greenenergyprojects/electro-vehicle-charger-met16/software/README.md

# Electrovehicle IEC 62196 Typ 2 charger

## Software

Each software product is located in a subdirectory.
For software detail information, see the file *README.md* inside the software subdirectory. 

### Overview

-----------------------------------------------------------------------------------------------------
 Subdirectory                                                         | Description
 :------------------------------------------------------------------  | :---------------------
 [atmega328p_u1/ev-charge-control](atmega328p_u1/ev-charge-control)   | Default software for the Atmega328P on Arduino (see [README.md](atmega328p_u1/ev-charge-control/README.md)).
