greenenergyprojects/electro-vehicle-charger-met16/kicad/README.md

# Electrovehicle IEC 62196 Typ 2 charger met-16

## Issues / Test results

Issues can be found in file [dist/README.md](dist/README.md).

## PCB / Kicad project

Design files can be found in the [same directory](./).

## Tapeout / Manufactering data

Manufactering data can be found in subdirectory [dist](dist).
