greenenergyprojects/electro-vehicle-charger-met16/docs/messung_netzspannung_2019-11-24/README.md

# Measurment Grid-Voltage

* yellow curve: grid voltage
  RIGOL MSO2204, 1:10 probe on resistor voltage divider 1:5 (ebay 253045608366)
  1/50: 2V/DIV => 100V/DIV

* blue curve: voltage sensor output MVOLT (J9-2)
