greenenergyprojects/electro-vehicle-charger-met16/docs/EV-AC-Charging.png

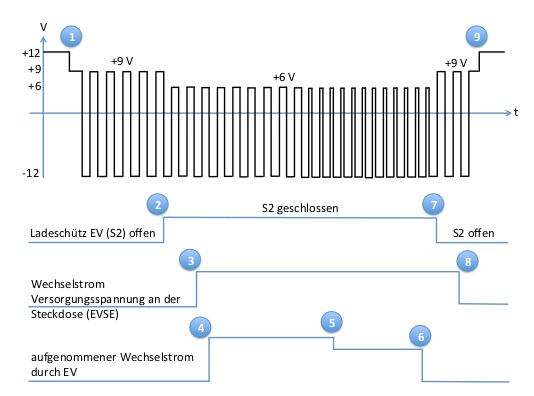
docs/EV-AC-Charging.png
