greenenergyprojects/electro-vehicle-charger-met16/kicad/dist/ev-charger-met16_3dview-bottom.png

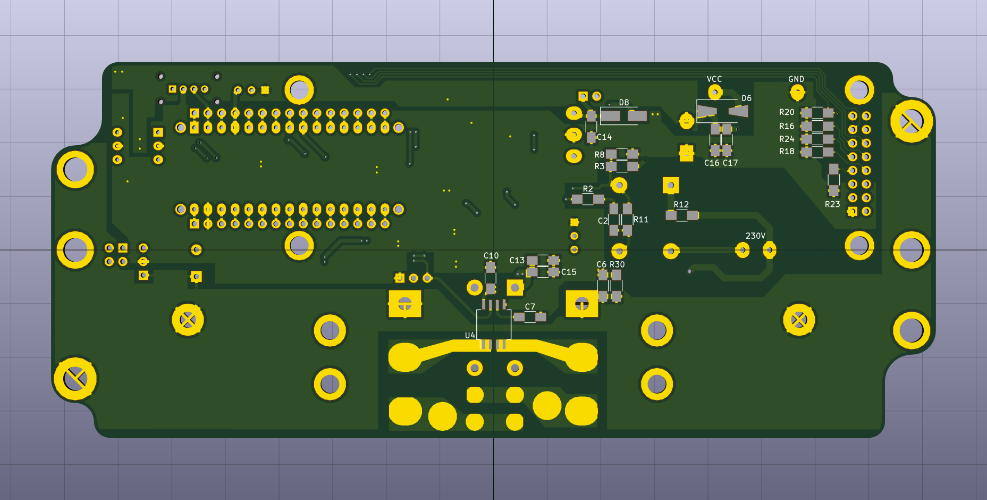
kicad/dist/ev-charger-met16_3dview-bottom.png
