greenenergyprojects/electro-vehicle-charger-met16/kicad/dist/ev-charger-met16_3dview-top.png

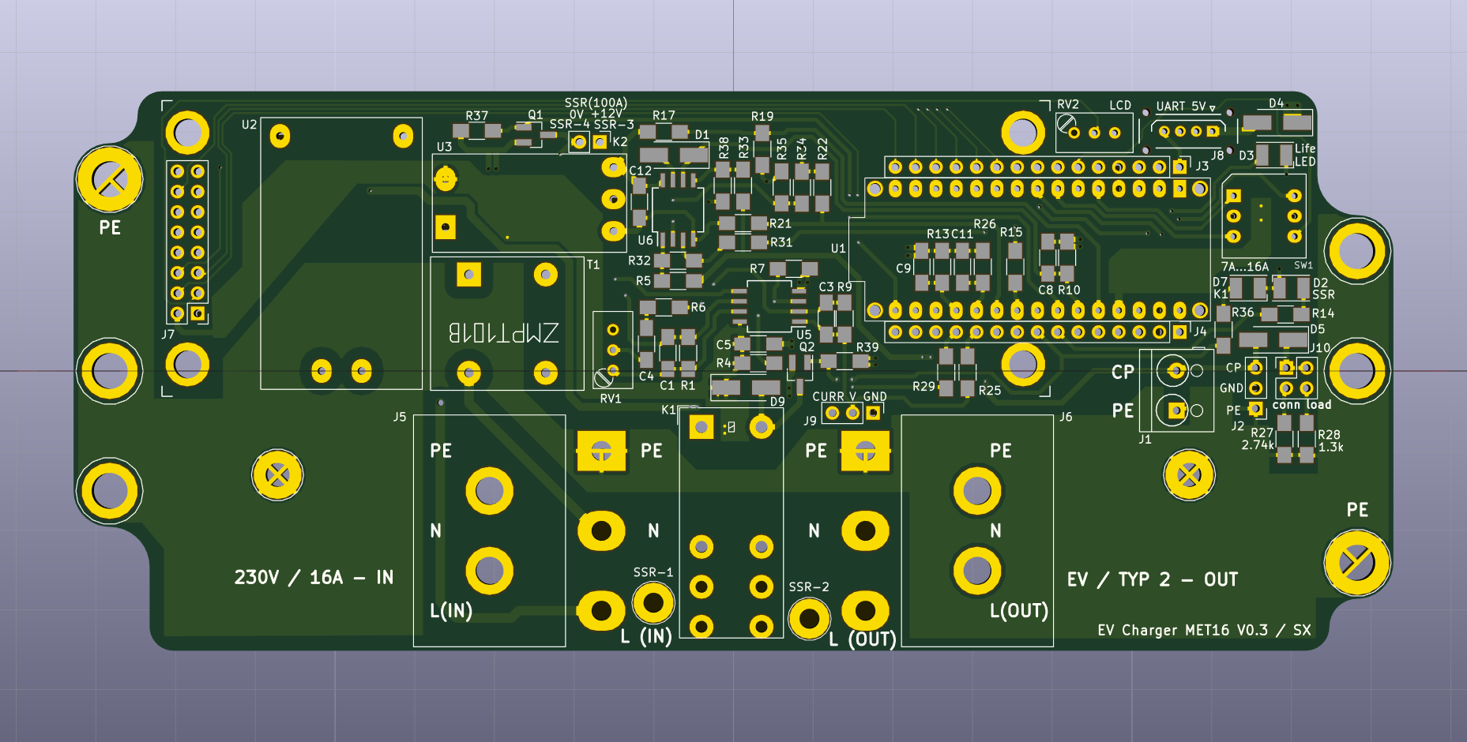
kicad/dist/ev-charger-met16_3dview-top.png
