greenenergyprojects/electro-vehicle-charger-met16/kicad/dist/ev-charger-met16_v0.3-open-withoutLCD.jpg

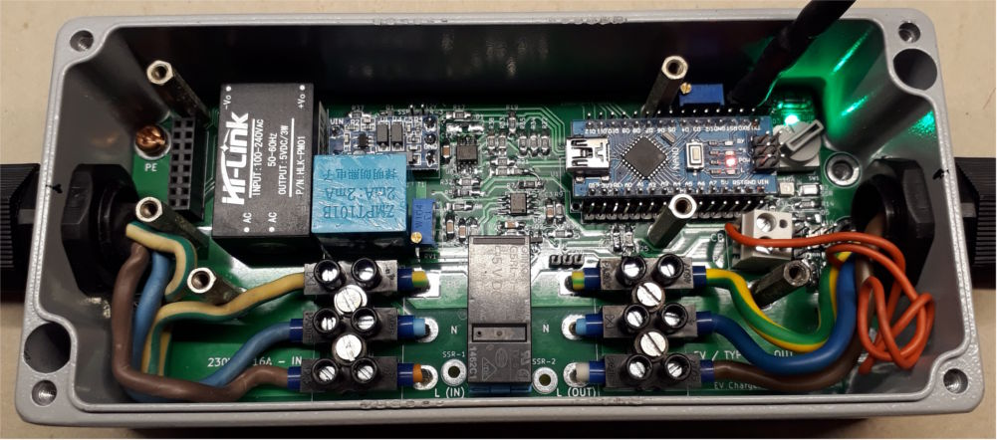
kicad/dist/ev-charger-met16_v0.3-open-withoutLCD.jpg
