greenenergyprojects/electro-vehicle-charger-met16/kicad/problems/voltage-tranformer_ebay-232542976388/zmpt101b-schematic.png

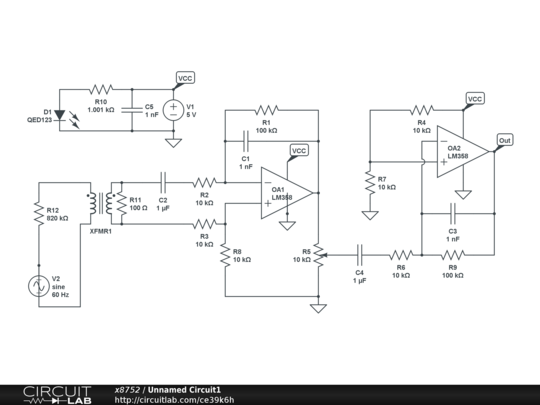
kicad/problems/voltage-tranformer_ebay-232542976388/zmpt101b-schematic.png
