greenenergyprojects/electro-vehicle-charger-met16/kicad/dist/ev-charger-met16_bom.ods

Source: | /work/sx/gep/electro-vehicle-charger-met16/kicad/ev-charger-met16.sch
Date: | So 05 Aug 2018 16:30:13 CEST
Tool: | Eeschema 4.0.7-e2-6376~61~ubuntu18.04.1
Component Count: | 91
Ref | Value | Footprint | Datasheet | Manufacturer | Vendor
C1 | 1nF | Capacitors_SMD:C_1206_HandSoldering
C2 | 1uF | Capacitors_SMD:C_1206_HandSoldering
C3 | 1nF | Capacitors_SMD:C_1206_HandSoldering
C4 | 1uF | Capacitors_SMD:C_1206_HandSoldering
C5 | 22nF | Capacitors_SMD:C_1206_HandSoldering
C6 | 100n | Capacitors_SMD:C_1206_HandSoldering
C7 | 1n | Capacitors_SMD:C_1206_HandSoldering
C8 | 1u | Capacitors_SMD:C_1206_HandSoldering
C9 | 100n | Capacitors_SMD:C_1206_HandSoldering
C10 | 100n | Capacitors_SMD:C_1206_HandSoldering
C11 | 100n | Capacitors_SMD:C_1206_HandSoldering
C12 | 22n | Capacitors_SMD:C_1206_HandSoldering
C13 | 1u | Capacitors_SMD:C_1206_HandSoldering
C14 | 220n | Capacitors_SMD:C_1206_HandSoldering
C15 | 100n | Capacitors_SMD:C_1206_HandSoldering
C16 | 100n | Capacitors_SMD:C_1206_HandSoldering
C17 | 1u | Capacitors_SMD:C_1206_HandSoldering
D1 | D_Schottky | Diodes_SMD:D_SMA_Handsoldering
D2 | rot | LEDs:LED_PLCC-2
D3 | grün | LEDs:LED_PLCC-2
D4 | D_Schottky | Diodes_SMD:D_SMA_Handsoldering
D5 | D_Schottky | Diodes_SMD:D_SMA_Handsoldering
D6 | D_Schottky | Diodes_SMD:D_SMA-SMB_Universal_Handsoldering
D7 | blau | LEDs:LED_PLCC-2
D8 | D_Schottky | Diodes_SMD:D_SMA_Handsoldering
D9 | D_Schottky | Diodes_SMD:D_SMA_Handsoldering
J1 | Screw_Terminal_01x02 | Project:Terminalblock-2x-5mm
J2 | Conn_01x03 | Pin_Headers:Pin_Header_Straight_1x03_Pitch2.54mm
J3 | Conn_01x15 | Pin_Headers:Pin_Header_Straight_1x15_Pitch2.54mm
J4 | Conn_01x15 | Pin_Headers:Pin_Header_Straight_1x15_Pitch2.54mm
J5 | Lusterklemme-6mm2-40A | Project:Lusterklemme-PA30P-6mm2-40A-x3-N
J6 | Lusterklemme-6mm2-40A | Project:Lusterklemme-PA30P-6mm2-40A-x3-S
J7 | LCD-Sure | Project:LCD-Sure-shifted-064
J8 | UART-Harwin4 | Connectors_Harwin:Harwin_LTek-Male_04x2.00mm_Straight_StrainRelief
J9 | Conn_01x03 | Pin_Headers:Pin_Header_Straight_1x03_Pitch2.54mm
J10 | Conn_02x02_Counter_Clockwise | Pin_Headers:Pin_Header_Straight_2x02_Pitch2.54mm
J12 | Conn_01x01 | Project:Solder_via_5x5_forWire4mm2
J13 | Conn_01x01 | Project:Solder_via_5x5_forWire4mm2
K1 | Omron_G5RL-1-E | Relays_THT:Relay_DPDT_Panasonic_JW2
K2 | Conn_01x02 | Pin_Headers:Pin_Header_Straight_1x02_Pitch2.54mm
Q1 | FDV303N | TO_SOT_Packages_SMD:SOT-23_Handsoldering
Q2 | FDV303N | TO_SOT_Packages_SMD:SOT-23_Handsoldering
R1 | 100k | Resistors_SMD:R_1206_HandSoldering
R2 | 10k | Resistors_SMD:R_1206_HandSoldering
R3 | 10k | Resistors_SMD:R_1206_HandSoldering
R4 | 10k | Resistors_SMD:R_1206_HandSoldering
R5 | 1k | Resistors_SMD:R_1206_HandSoldering
R6 | 10k | Resistors_SMD:R_1206_HandSoldering
R7 | 10k | Resistors_SMD:R_1206_HandSoldering
R8 | 10k | Resistors_SMD:R_1206_HandSoldering
R9 | 100k | Resistors_SMD:R_1206_HandSoldering
R10 | 100M | Resistors_SMD:R_1206_HandSoldering
R11 | 100 | Resistors_SMD:R_1206_HandSoldering
R12 | 820k | Resistors_SMD:R_1206_HandSoldering
R13 | 1k | Resistors_SMD:R_1206_HandSoldering
R14 | 560R | Resistors_SMD:R_1206_HandSoldering
R15 | 560R | Resistors_SMD:R_1206_HandSoldering
R16 | 47k | Resistors_SMD:R_1206_HandSoldering
R17 | 33k | Resistors_SMD:R_1206_HandSoldering
R18 | 47k | Resistors_SMD:R_1206_HandSoldering
R19 | 2k2 | Resistors_SMD:R_1206_HandSoldering
R20 | 100k | Resistors_SMD:R_1206_HandSoldering
R21 | 27k | Resistors_SMD:R_1206_HandSoldering
R22 | 10k | Resistors_SMD:R_1206_HandSoldering
R23 | 47k | Resistors_SMD:R_1206_HandSoldering
R24 | 47k | Resistors_SMD:R_1206_HandSoldering
R25 | 3k3 | Resistors_SMD:R_1206_HandSoldering
R26 | 1k | Resistors_SMD:R_1206_HandSoldering
R27 | 2.74k | Resistors_SMD:R_1206_HandSoldering
R28 | 1.3k | Resistors_SMD:R_1206_HandSoldering
R29 | 47k | Resistors_SMD:R_1206_HandSoldering
R30 | 0R | Resistors_SMD:R_1206_HandSoldering
R31 | 15k | Resistors_SMD:R_1206_HandSoldering
R32 | 100M | Resistors_SMD:R_1206_HandSoldering
R33 | 120k | Resistors_SMD:R_1206_HandSoldering
R34 | 33k | Resistors_SMD:R_1206_HandSoldering
R35 | 3k3 | Resistors_SMD:R_1206_HandSoldering
R36 | 560R | Resistors_SMD:R_1206_HandSoldering
R37 | 47k | Resistors_SMD:R_1206_HandSoldering
R38 | 10k | Resistors_SMD:R_1206_HandSoldering
R39 | 47k | Resistors_SMD:R_1206_HandSoldering
RV1 | 100k | Potentiometers:Potentiometer_Trimmer_Bourns_3296W
RV2 | 10K | Potentiometers:Potentiometer_Trimmer_Bourns_3296W
SW1 | SW_PT65-501 | Project:SW_DIP_x3_W7.62mm_PT65-501
T1 | Transformer_1P_1S | Project:Transformer-zmpt101b_ebay-121438904988
U1 | ARDUINO-NANO | Project:Arduino-Nano
U2 | HLK-PM01 | Project:HLK_PM01
U3 | ebay-253052736386 | Project:ebay-253052736386
U4 | ACS712 | Housings_SOIC:SO-8_5.3x6.2mm_Pitch1.27mm
U5 | LM358 | Housings_SOIC:SO-8_5.3x6.2mm_Pitch1.27mm
U6 | AD822 | Housings_SOIC:SO-8_5.3x6.2mm_Pitch1.27mm
