greenenergyprojects/electro-vehicle-charger-met16/kicad/problems/voltage-tranformer_ebay-232542976388/oszi.jpg

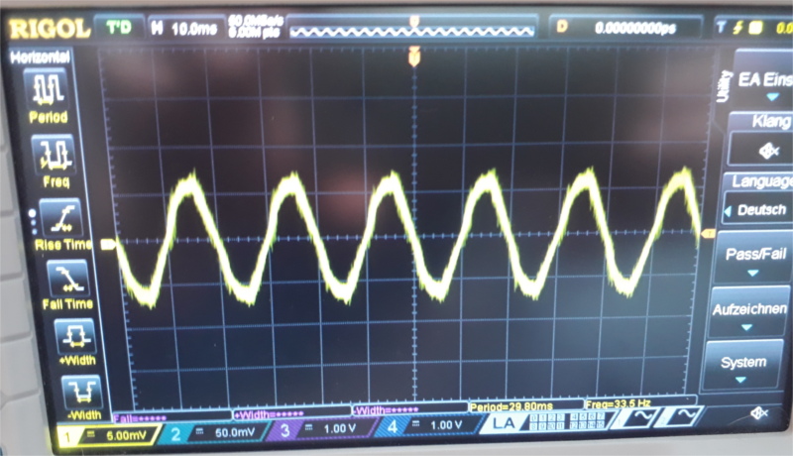
kicad/problems/voltage-tranformer_ebay-232542976388/oszi.jpg
