greenenergyprojects/electro-vehicle-charger-met16/kicad/dist/ev-charger-met16_schematic.pdf

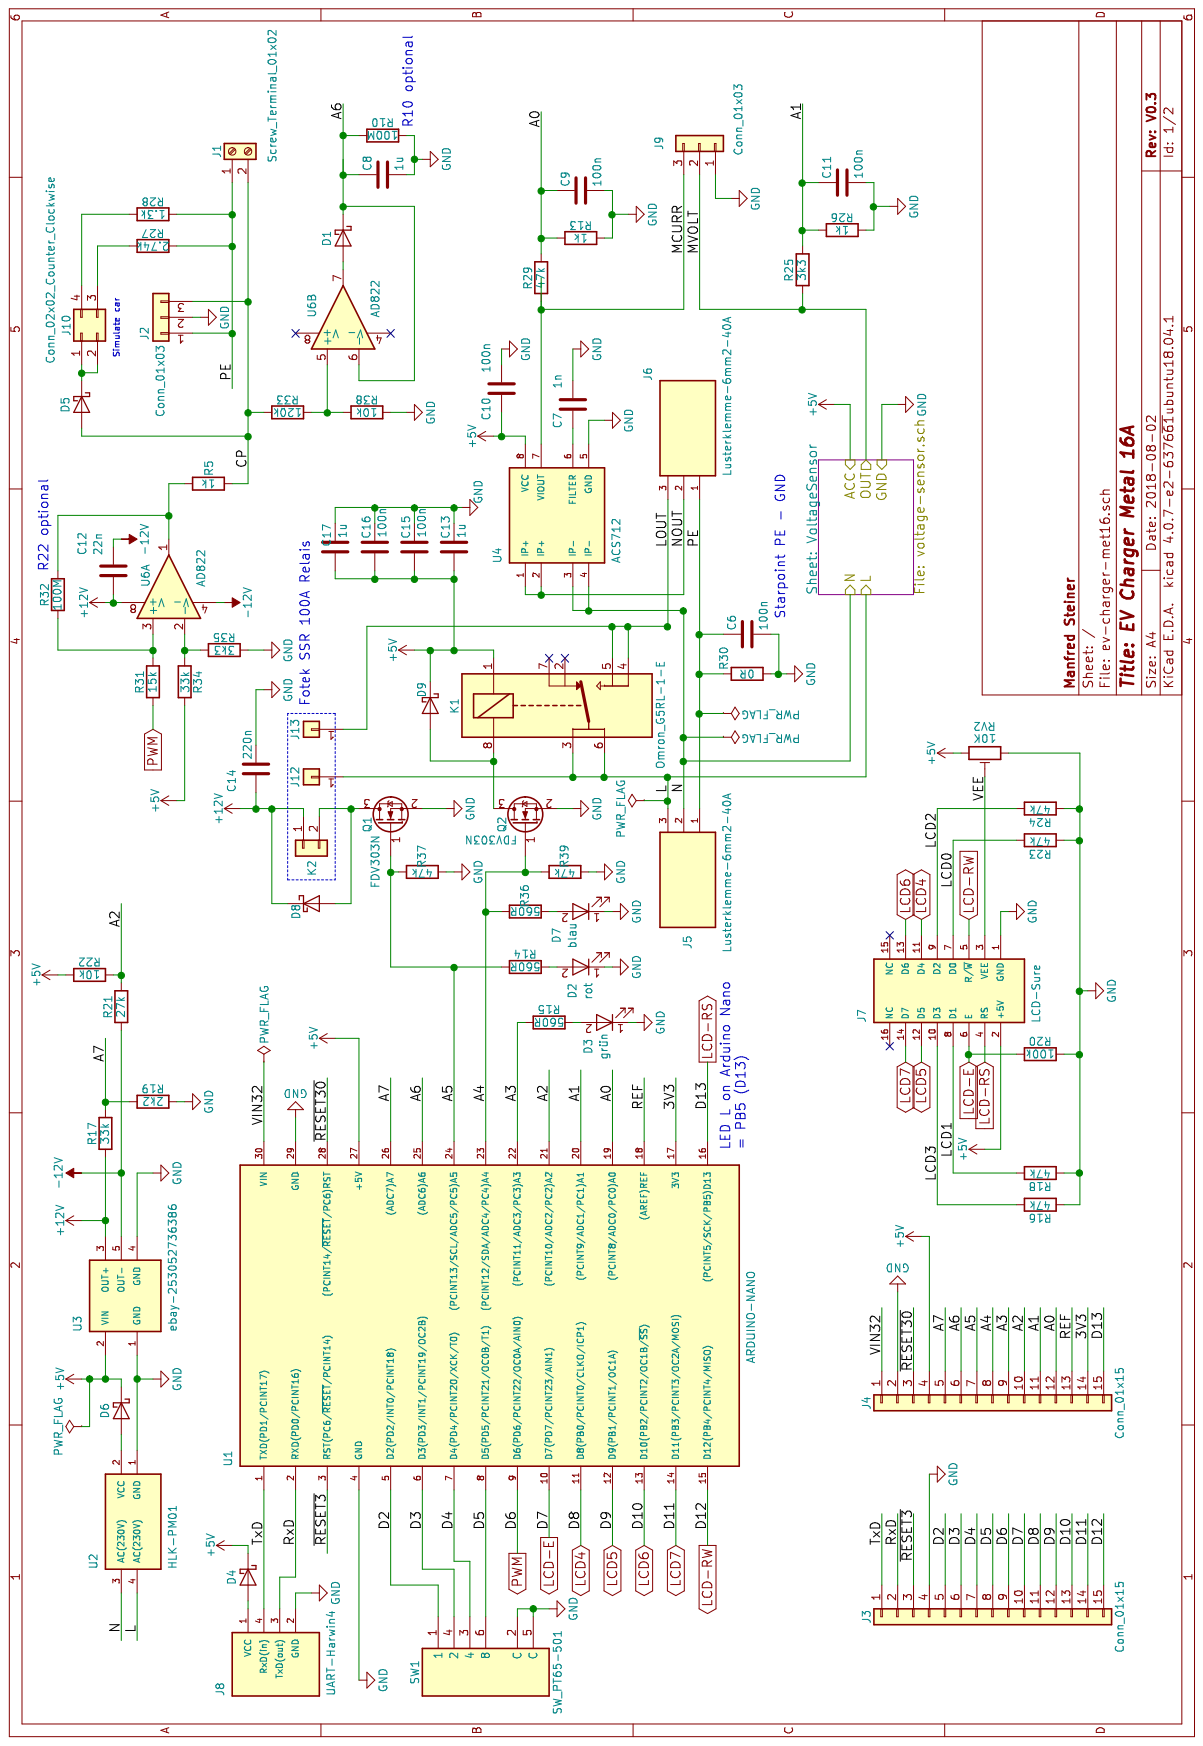
[picture p10: page 1]

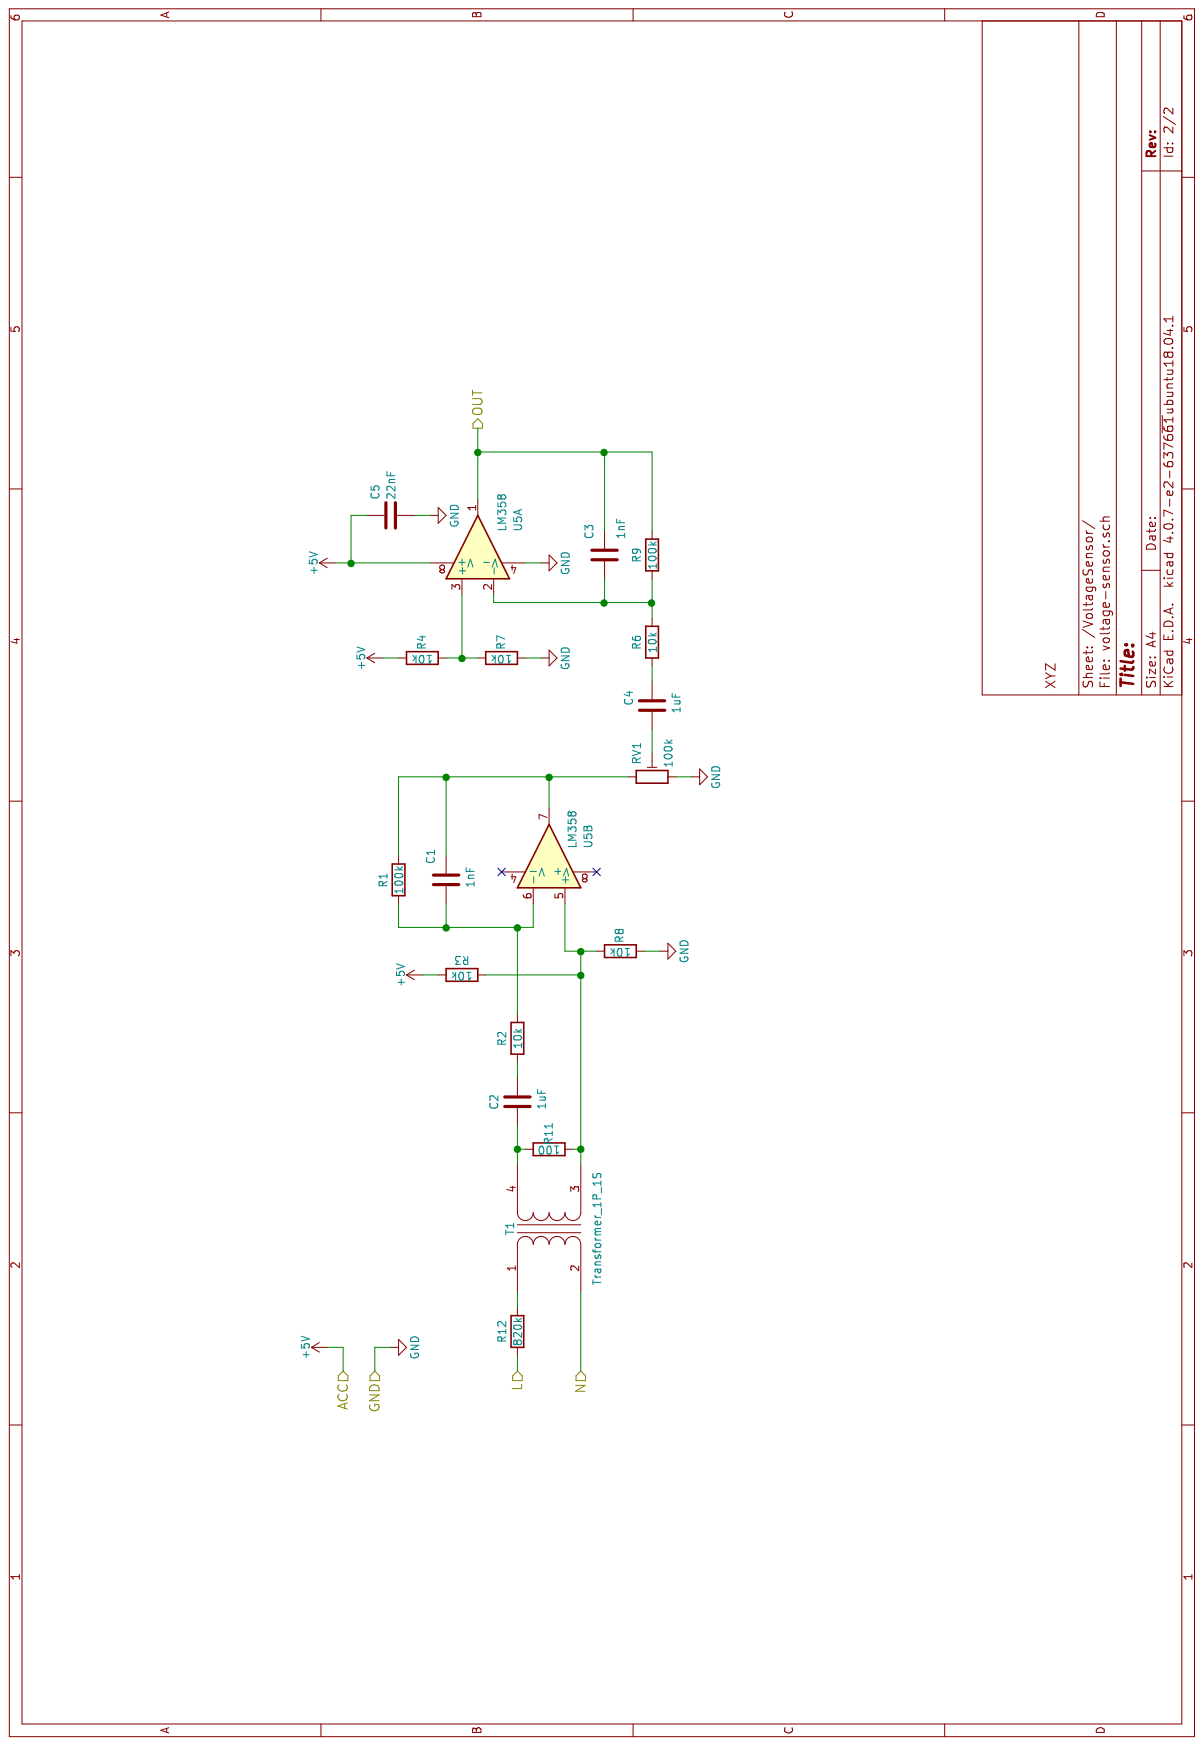
[picture p11: page 2]
