greenenergyprojects/electro-vehicle-charger-met16/kicad/dist/ev-charger-met16_schematic_sw.pdf

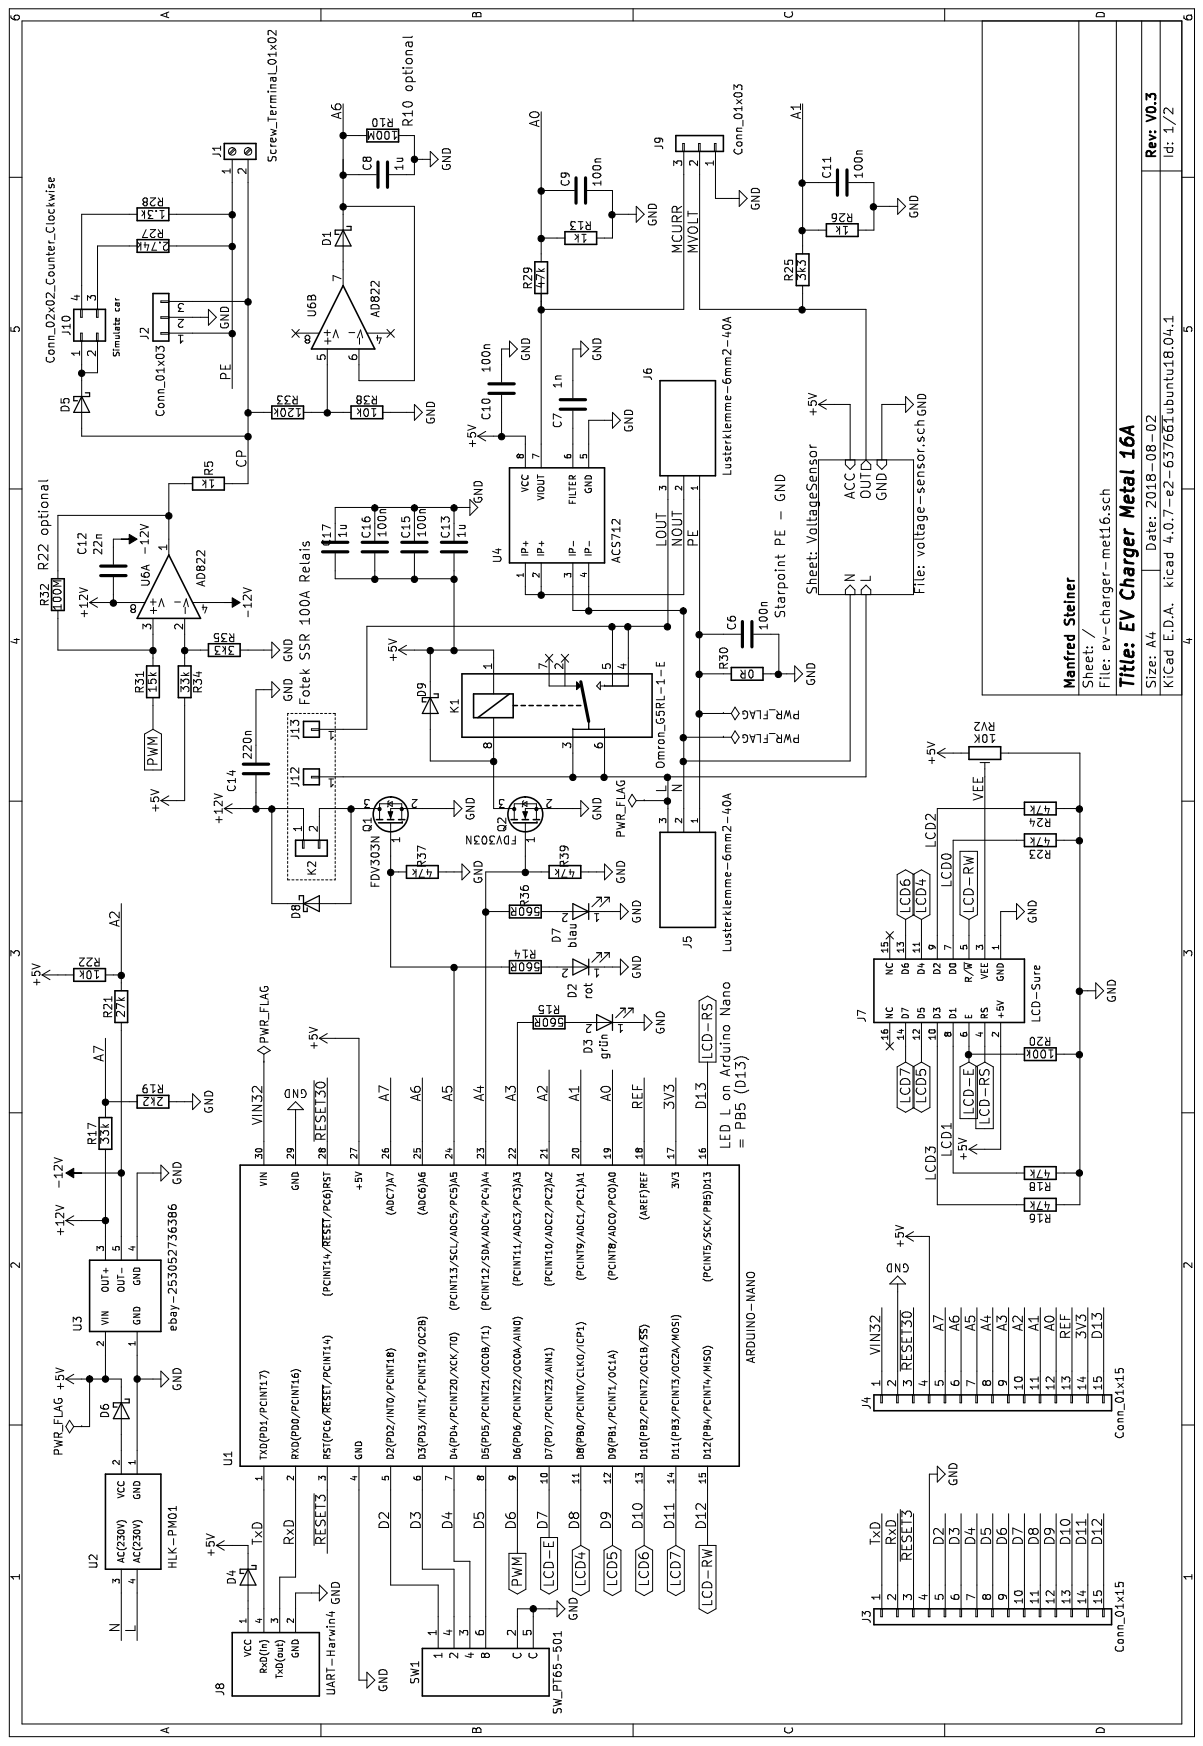
[picture p12: page 1]

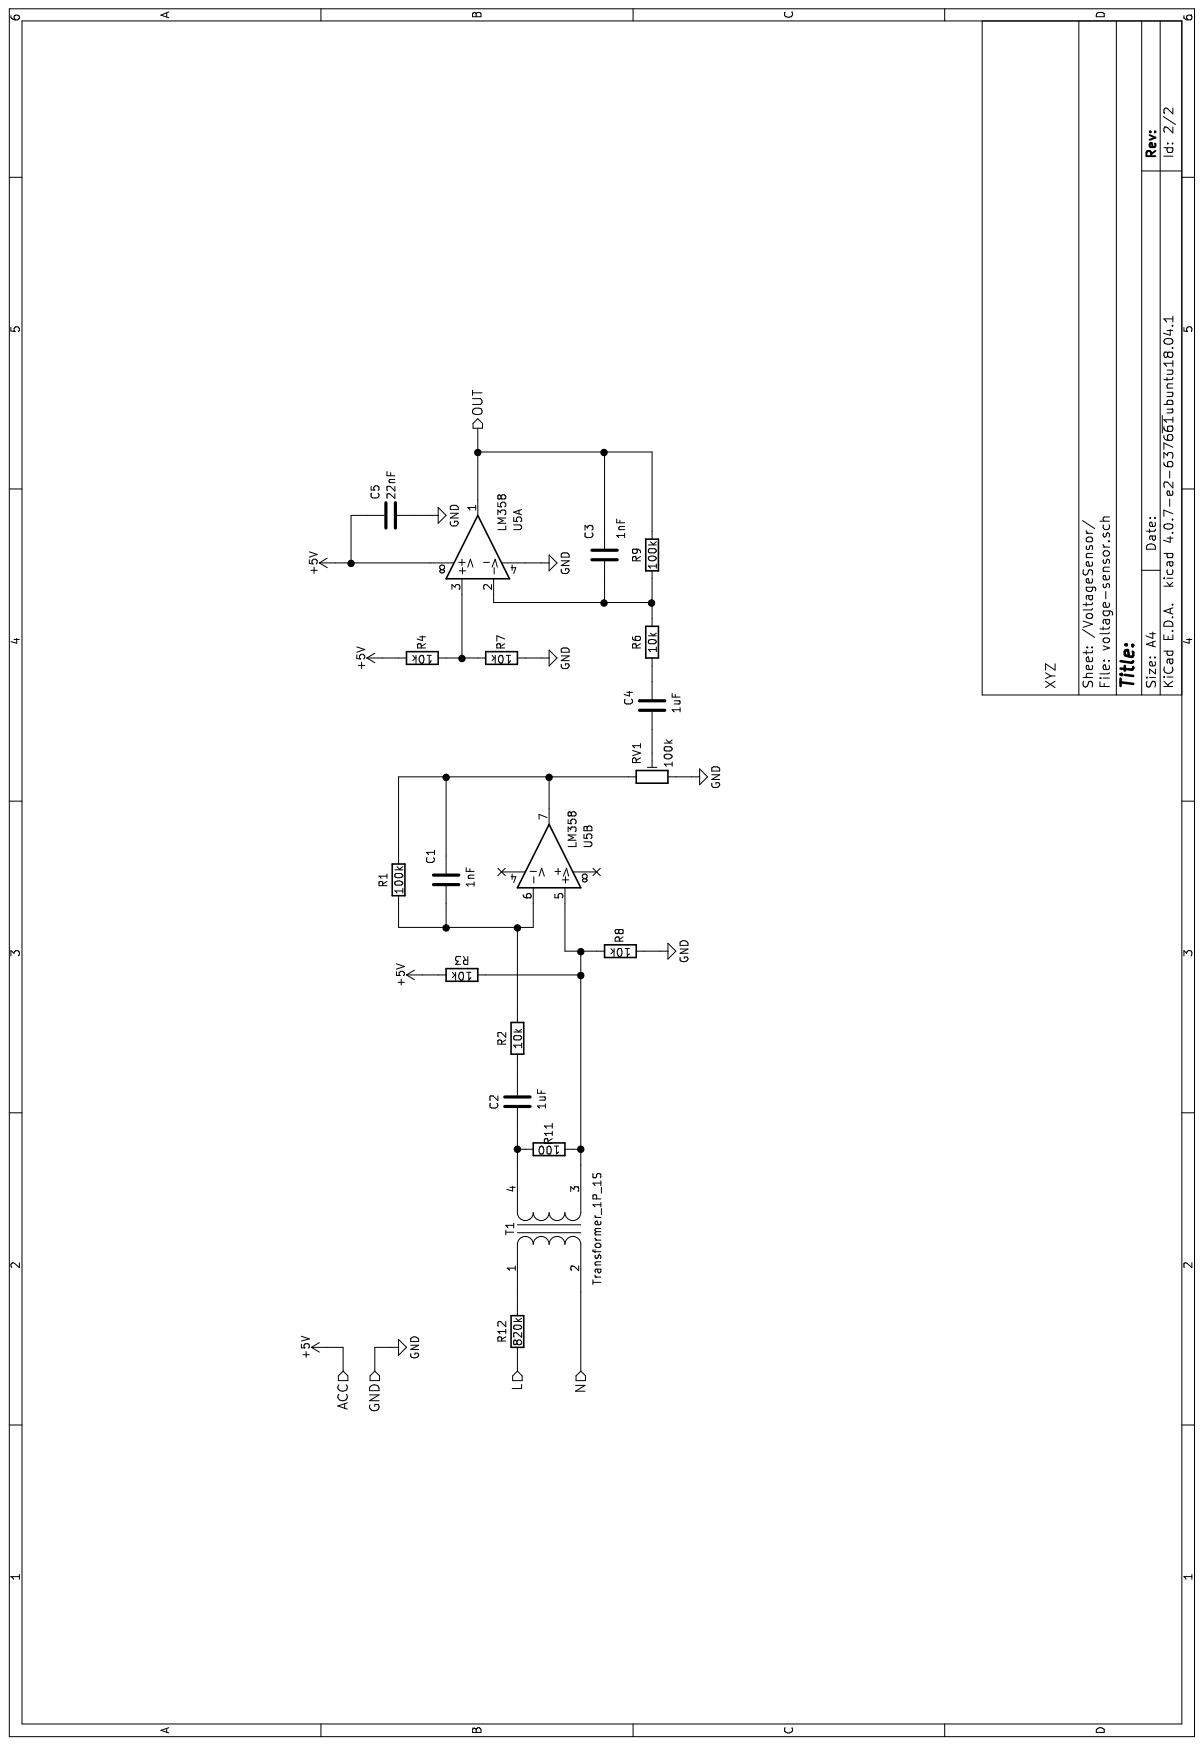
[picture p13: page 2]
