greenenergyprojects/electro-vehicle-charger-met16/kicad/ev-charger-met16.kicad_pcb

## KiCad design kicad/ev-charger-met16.kicad_pcb (2018-08-05)

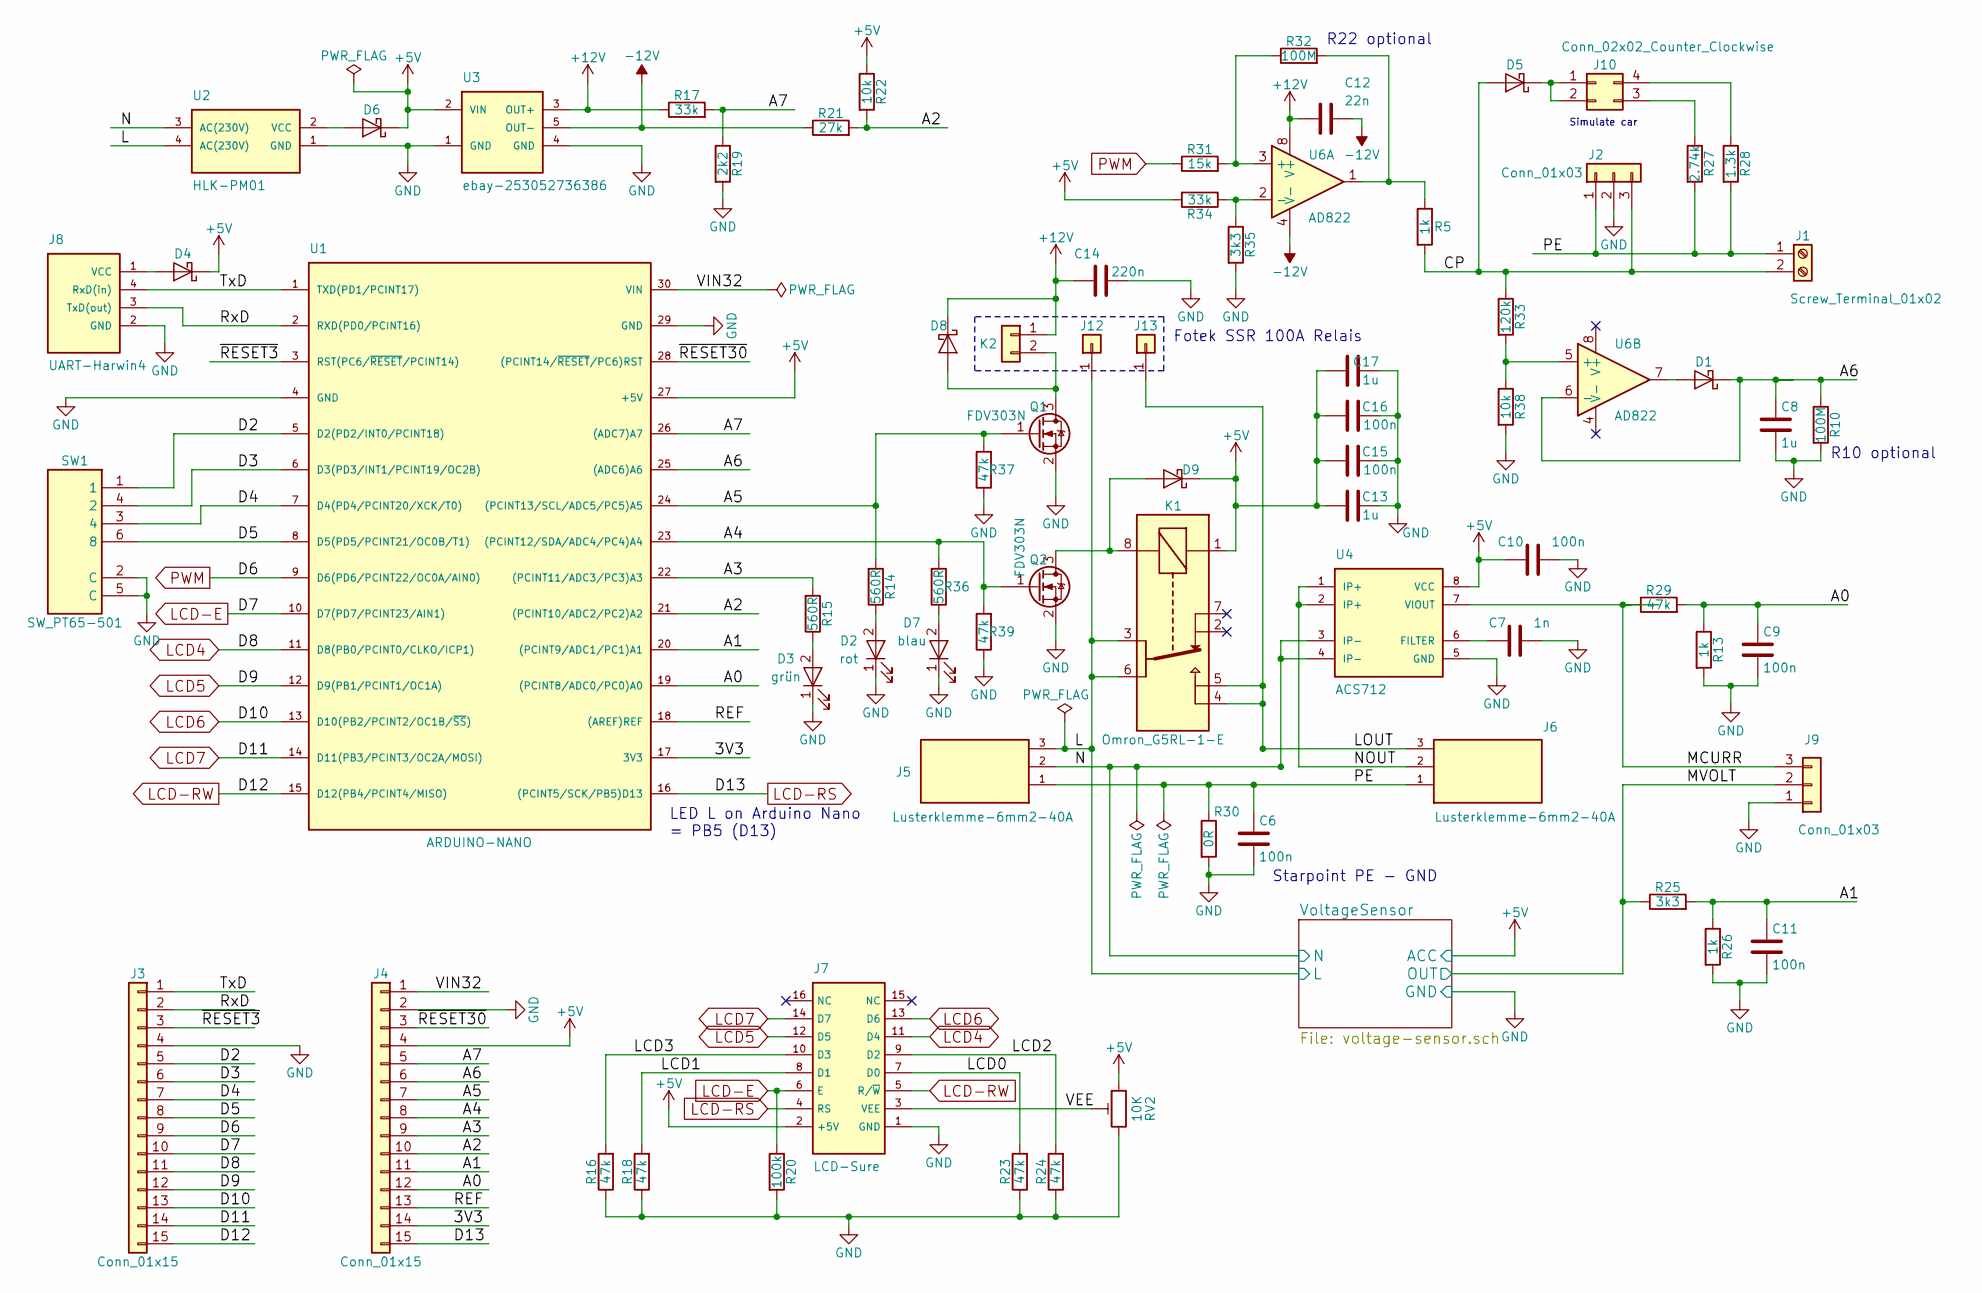
[picture p21: schematic ev-charger-met16.sch, EV Charger Metal 16A]

Parts:
C6, C9, C10, C11, C15, C16: 100n; C_1206_HandSoldering
C7: 1n; C_1206_HandSoldering
C8, C13, C17: 1u; C_1206_HandSoldering
C12: 22n; C_1206_HandSoldering
C14: 220n; C_1206_HandSoldering
D1, D4, D5, D8, D9: D_Schottky; D_SMA_Handsoldering
D2: rot; LED_PLCC-2
D3: grün; LED_PLCC-2
D6: D_Schottky; D_SMA-SMB_Universal_Handsoldering
D7: blau; LED_PLCC-2
J1: Screw_Terminal_01x02; Terminalblock-2x-5mm
J2, J9: Conn_01x03; Pin_Header_Straight_1x03_Pitch2.54mm
J3, J4: Conn_01x15; Pin_Header_Straight_1x15_Pitch2.54mm
J5: Lusterklemme-6mm2-40A; Lusterklemme-PA30P-6mm2-40A-x3-N
J6: Lusterklemme-6mm2-40A; Lusterklemme-PA30P-6mm2-40A-x3-S
J7: LCD-Sure; LCD-Sure-shifted-064
J8: UART-Harwin4; Harwin_LTek-Male_04x2.00mm_Straight_StrainRelief
J10: Conn_02x02_Counter_Clockwise; Pin_Header_Straight_2x02_Pitch2.54mm
J12, J13: Conn_01x01; Solder_via_5x5_forWire4mm2
K1: Omron_G5RL-1-E; Relay_DPDT_Panasonic_JW2
K2: Conn_01x02; Pin_Header_Straight_1x02_Pitch2.54mm
Q1, Q2: FDV303N; SOT-23_Handsoldering
R5, R13, R26: 1k; R_1206_HandSoldering
R10, R32: 100M; R_1206_HandSoldering
R14, R15, R36: 560R; R_1206_HandSoldering
R16, R18, R23, R24, R29, R37, R39: 47k; R_1206_HandSoldering
R17, R34: 33k; R_1206_HandSoldering
R19: 2k2; R_1206_HandSoldering
R20: 100k; R_1206_HandSoldering
R21: 27k; R_1206_HandSoldering
R22, R38: 10k; R_1206_HandSoldering
R25, R35: 3k3; R_1206_HandSoldering
R27: 2.74k; R_1206_HandSoldering
R28: 1.3k; R_1206_HandSoldering
R30: 0R; R_1206_HandSoldering
R31: 15k; R_1206_HandSoldering
R33: 120k; R_1206_HandSoldering
RV2: 10K; Potentiometer_Trimmer_Bourns_3296W
SW1: SW_PT65-501; SW_DIP_x3_W7.62mm_PT65-501
U1: ARDUINO-NANO; Arduino-Nano
U2: HLK-PM01; HLK_PM01
U3: ebay-253052736386
U4: ACS712; SO-8_5.3x6.2mm_Pitch1.27mm
U6: AD822; SO-8_5.3x6.2mm_Pitch1.27mm

Connections:
+5V: C10.2, C13.1, C15.1, C16.1, C17.1, D4.1 (K), D6.1 (K), D9.1 (K), J4.4, J7.2 (+5V), K1.1, R22.1, R34.2, RV2.1, U1.27 (+5V), U3.2 (VIN), U4.8 (VCC); also elsewhere on the board
+12V: C12.2, C14.1, D8.1 (K), K2.1, R17.1, U3.3 (OUT+), U6.8 (V+)
-12V: C12.1, R21.1, U3.5 (OUT-), U6.4 (V-)
/3V3: J4.14, U1.17 (3V3)
/A0: C9.1, J4.12, R13.1, R29.2, U1.19 ((PCINT8/ADC0/PC0)A0)
/A1: C11.1, J4.11, R25.2, R26.1, U1.20 ((PCINT9/ADC1/PC1)A1)
/A2: J4.10, R21.2, R22.2, U1.21 ((PCINT10/ADC2/PC2)A2)
/A3: J4.9, R15.2, U1.22 ((PCINT11/ADC3/PC3)A3)
/A4: J4.8, Q2.1 (G), R36.2, R39.2, U1.23 ((PCINT12/SDA/ADC4/PC4)A4)
/A5: J4.7, Q1.1 (G), R14.2, R37.2, U1.24 ((PCINT13/SCL/ADC5/PC5)A5)
/A6: C8.1, D1.1 (K), J4.6, R10.1, U1.25 ((ADC6)A6), U6.6 (-)
/A7: J4.5, R17.2, R19.1, U1.26 ((ADC7)A7)
/CP: D5.2 (A), J1.2, J2.3, R5.2, R33.1
/D2: J3.5, SW1.1, U1.5 (D2(PD2/INT0/PCINT18))
/D3: J3.6, SW1.4 (2), U1.6 (D3(PD3/INT1/PCINT19/OC2B))
/D4: J3.7, SW1.3 (4), U1.7 (D4(PD4/PCINT20/XCK/T0))
/D5: J3.8, SW1.6 (8), U1.8 (D5(PD5/PCINT21/OC0B/T1))
/L: J5.3, J12.1, K1.3, K1.6, U2.4 (AC(230V)); also elsewhere on the board
/LCD0: J7.7 (D0), R23.2
/LCD1: J7.8 (D1), R18.2
/LCD2: J7.9 (D2), R24.2
/LCD3: J7.10 (D3), R16.2
/LOUT: J6.3, J13.1, K1.4, K1.5
/MCURR: J9.3, R29.1, U4.7 (VIOUT)
/MVOLT: J9.2, R25.1; also elsewhere on the board
/N: J5.2, U2.3 (AC(230V)), U4.3 (IP-), U4.4 (IP-); also elsewhere on the board
/NOUT: J6.2, U4.1 (IP+), U4.2 (IP+)
/PE: C6.1, J1.1, J2.1, J5.1, J6.1, R27.2, R28.2, R30.1
/REF: J4.13, U1.18 ((AREF)REF)
/RxD: J3.2, J8.3 (TxD(out)), U1.2 (RXD(PD0/PCINT16))
/TxD: J3.1, J8.4 (RxD(in)), U1.1 (TXD(PD1/PCINT17))
/VEE: J7.3 (VEE), RV2.2
/VIN32: J4.1, U1.30 (VIN)
/~RESET3~: J3.3, U1.3 (RST(PC6/~RESET~/PCINT14))
/~RESET30~: J4.3, U1.28 ((PCINT14/~RESET~/PC6)RST)
GND: C6.2, C7.1, C8.2, C9.2, C10.1, C11.2, C13.2, C14.2, C15.2, C16.2, C17.2, D2.1 (K), D3.1 (K), D7.1 (K), J2.2, J3.4, J4.2, J7.1 (GND), J8.2 (GND), J9.1, Q1.2 (S), Q2.2 (S), R10.2, R13.2, R16.1, R18.1, R19.2, R20.2, R23.1, R24.1, R26.2, R30.2, R35.2, R37.1, R38.2, R39.1, RV2.3, SW1.2 (C), SW1.5 (C), U1.4 (GND), U1.29 (GND), U2.1 (GND), U3.1 (GND), U3.4 (GND), U4.5 (GND); also elsewhere on the board
LCD4: J3.11, J7.11 (D4), U1.11 (D8(PB0/PCINT0/CLKO/ICP1))
LCD5: J3.12, J7.12 (D5), U1.12 (D9(PB1/PCINT1/OC1A))
LCD6: J3.13, J7.13 (D6), U1.13 (D10(PB2/PCINT2/OC1B/~SS~))
LCD7: J3.14, J7.14 (D7), U1.14 (D11(PB3/PCINT3/OC2A/MOSI))
LCD-E: J3.10, J7.6 (E), R20.1, U1.10 (D7(PD7/PCINT23/AIN1))
LCD-RS: J4.15, J7.4 (RS), U1.16 ((PCINT5/SCK/PB5)D13)
LCD-RW: J3.15, J7.5 (R/~W~), U1.15 (D12(PB4/PCINT4/MISO))
unnamed: C7.2, U4.6 (FILTER)
unnamed: D1.2 (A), U6.7
unnamed: D2.2 (A), R14.1
unnamed: D3.2 (A), R15.1
unnamed: D4.2 (A), J8.1 (VCC)
unnamed: D5.1 (K), J10.1, J10.2
unnamed: D6.2 (A), U2.2 (VCC)
unnamed: D7.2 (A), R36.1
unnamed: D8.2 (A), K2.2, Q1.3 (D)
unnamed: D9.2 (A), K1.8, Q2.3 (D)
unnamed: J10.3, R27.1
unnamed: J10.4, R28.1
unnamed: R31.2, R32.1, U6.3 (+)
unnamed: R5.1, R32.2, U6.1
unnamed: R33.2, R38.1, U6.5 (+)
unnamed: R34.1, R35.1, U6.2 (-)
PWM: J3.9, R31.1, U1.9 (D6(PD6/PCINT22/OC0A/AIN0))

Notes on the sheet:
Starpoint PE - GND
Simulate car
R10 optional
R22 optional
LED L on Arduino Nano = PB5 (D13)
Fotek SSR 100A Relais

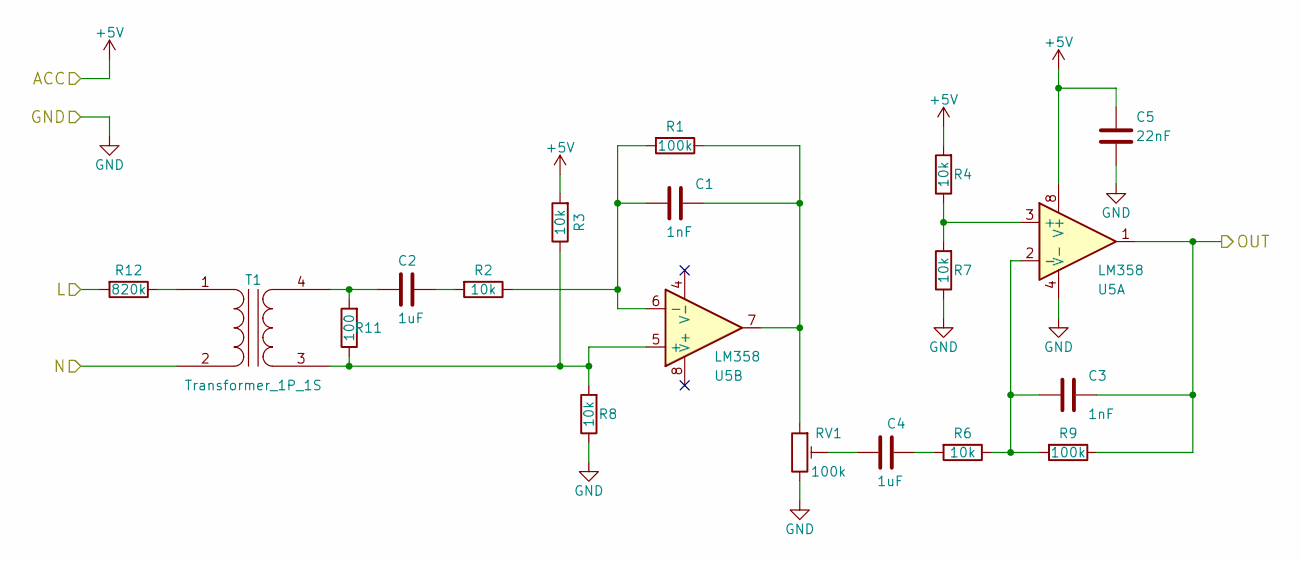
[picture p22: schematic voltage-sensor.sch]

Parts:
C1, C3: 1nF; C_1206_HandSoldering
C2, C4: 1uF; C_1206_HandSoldering
C5: 22nF; C_1206_HandSoldering
R1, R9: 100k; R_1206_HandSoldering
R2, R3, R4, R6, R7, R8: 10k; R_1206_HandSoldering
R11: 100; R_1206_HandSoldering
R12: 820k; R_1206_HandSoldering
RV1: 100k; Potentiometer_Trimmer_Bourns_3296W
T1: Transformer_1P_1S; Transformer-zmpt101b_ebay-121438904988
U5: LM358; SO-8_5.3x6.2mm_Pitch1.27mm

Connections:
+5V: C5.1, R3.2, R4.2, U5.8 (V+); also elsewhere on the board
/L: R12.2; also elsewhere on the board
/MVOLT: C3.1, R9.1, U5.1; also elsewhere on the board
/N: T1.2 (AB); also elsewhere on the board
GND: C5.2, R7.1, R8.1, RV1.3, U5.4 (V-); also elsewhere on the board
unnamed: C1.1, R1.1, RV1.1, U5.7
unnamed: C1.2, R1.2, R2.1, U5.6 (-)
unnamed: C2.1, R2.2
unnamed: C2.2, R11.2, T1.4 (SB)
unnamed: C3.2, R6.1, R9.2, U5.2 (-)
unnamed: C4.1, R6.2
unnamed: C4.2, RV1.2
unnamed: R4.1, R7.2, U5.3 (+)
unnamed: R3.1, R8.2, R11.1, T1.3 (SA), U5.5 (+)
unnamed: R12.1, T1.1 (AA)

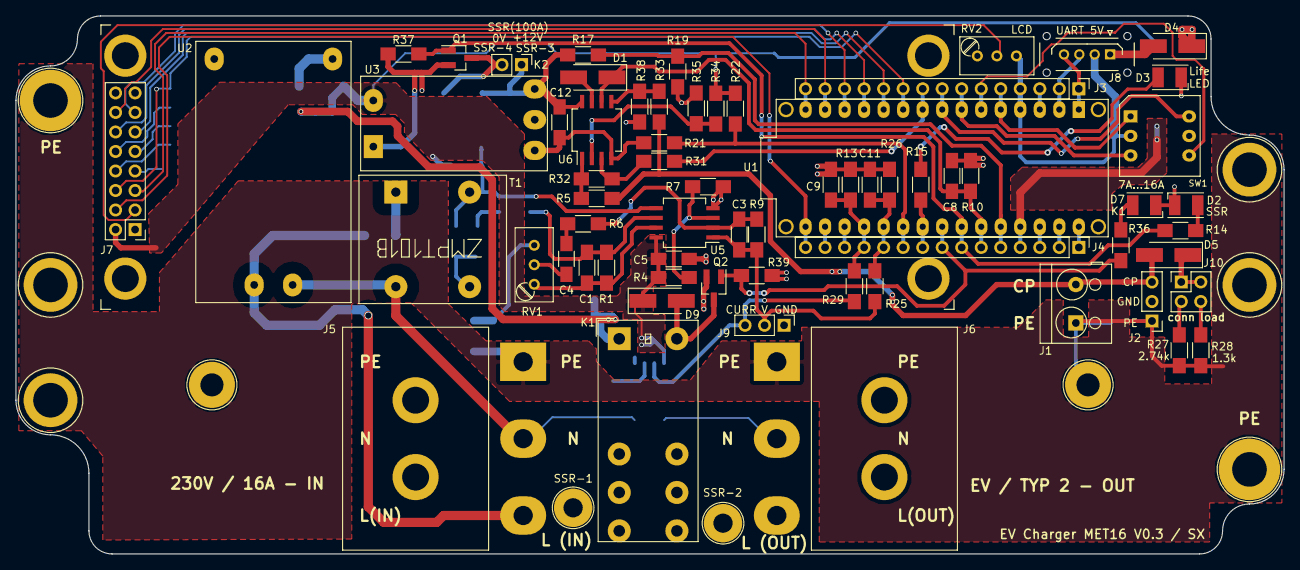
[picture p23: board ev-charger-met16.kicad_pcb from above]

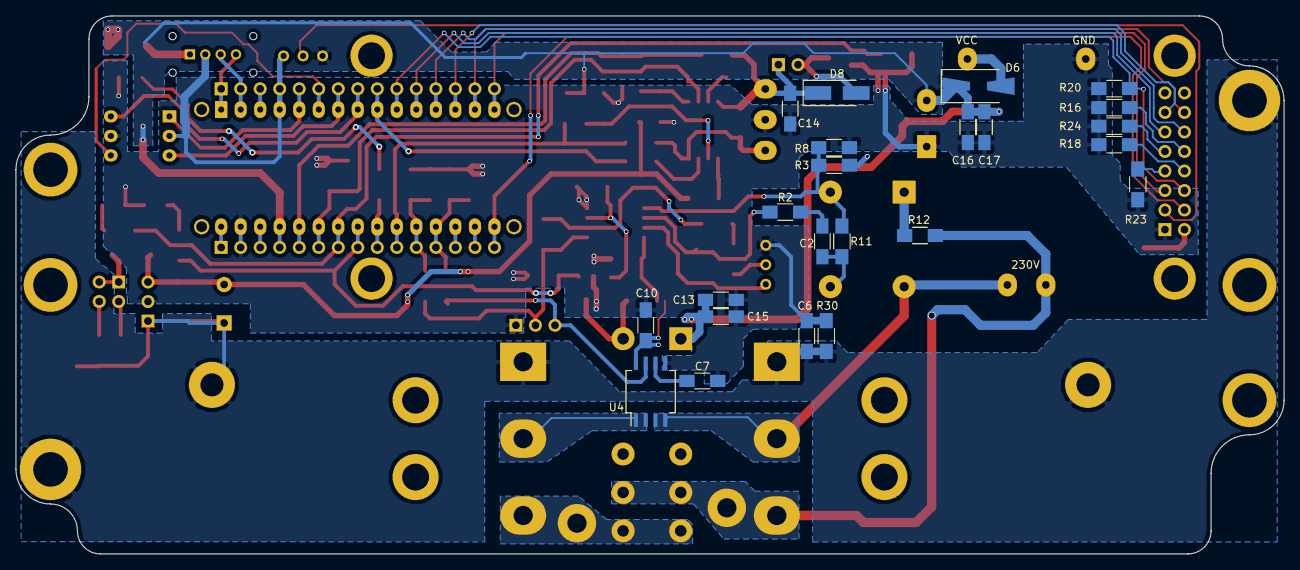
[picture p24: board ev-charger-met16.kicad_pcb from below]

Board: 2 copper layers, 165.0 x 70.0 mm, 91 parts (23 on the bottom side), 70 nets.
