greenenergyprojects/electro-vehicle-charger-met16/software/atmega328p_u1/ev-charge-control/src/global.h

#ifndef GLOBAL_H_INCLUDED_
#define GLOBAL_H_INCLUDED_

#define GLOBAL_UART0_BITRATE     57600
#define GLOBAL_UART0_RECBUFSIZE  16

#define GLOBAL_MONITOR_MAXARGV 4
#define GLOBAL_MONITOR
// #define GLOBAL_MONITOR_CMD_HEXDUMP
// #define GLOBAL_MONITOR_CMD_SETMEM

#define GLOBAL_U1_LCD 1

#endif // GLOBAL_H_INCLUDED_
