greenenergyprojects/electro-vehicle-charger-met16/(commit log)

2018-08-02 v0.2, first protoype
    [calculations.ods, ev-charger-met16.kicad_pcb, ev-charger-met16.sch, voltage-sensor.sch]
2018-08-05 Redesign v0.3 finished, gerber-files ready for print production
    [ev-charger-met16.kicad_pcb, ev-charger-met16.sch, ev-charger-met16_bom.ods, voltage-sensor.sch]
2018-08-05 update project settings
    [ev-charger-met16.kicad_pcb]
2019-10-30 v0.3 manufact. report / software for voltage upper/lower half measurment
    [ewma-filters.ods]
2019-11-11 ev-charge-control V0.3.1~20191111-103422
    [calculations.ods]
2019-11-13 Add images from v0.3 manufactured print
2019-11-13 Add image ev-charger-m16.jpg
2019-11-13 Update Software atmega328p_u1/ev-charge-control
